jimfinnis/blodwen/docs/blod2.pdf

THIS WAY IS FORWARDS

power switch
Science

Locomotion

Fit PCs
