jimfinnis/blodwen/firmware/master/src/hwconfig.h

/**
 * @file
 * File used to describe configuration options for Arduino files
 * which share source, such as MAYBEPROGMEM - which is set in the
 * master's version of this file
 * 
 */

#ifndef __REGCONFIG_H
#define __REGCONFIG_H

/// this code is on the master

#define MASTER	1



#endif /* __REGCONFIG_H */
