jimfinnis/blodwen/roverScript/udpclient.cpp

/**
 * \file
 * Brief description. Longer description.
 *
 * 
 * \author $Author$
 * \date $Date$
 */




#include <stdio.h>
#include <sys/socket.h>
#include <netinet/in.h>
#include <arpa/inet.h>
#include <unistd.h>
#include <strings.h>
#include <string.h>
#include <fcntl.h>
#include <stdlib.h>
#include "udpclient.h"

const char *hostName=DEFAULT_HOSTNAME;

bool udpSend(const char *msg){
    sockaddr_in servaddr;
    int fd = socket(AF_INET,SOCK_DGRAM,0);
    if(fd<0){
        perror("cannot open socket");
        return false;
    }
    
    bzero(&servaddr,sizeof(servaddr));
    servaddr.sin_family = AF_INET;
    servaddr.sin_addr.s_addr = inet_addr(hostName);
    servaddr.sin_port = htons(PORT);
    if (sendto(fd, msg, strlen(msg)+1, 0, // +1 to include terminator
               (sockaddr*)&servaddr, sizeof(servaddr)) < 0){
        perror("cannot send message");
        close(fd);
        return false;
    }
    close(fd);
    return true;
}
