jimfinnis/blodwen/(commit log)

2017-03-29 Changes to docs to reflect new power regime, and eagle files for the boards.
    [rover board-4.brd, rover board-4.sch]
2017-03-29 Library now build with -Wall -pedantic. Warnings remove. Missing method returns added!
    [motorsim.h, rover.h, sim.cpp, slave.h]
2019-04-21 Include missing sys/select.h to satisfy fd_set and friends
    [comms.h]
2019-04-21 Do not track built assets
2025-02-13 A couple of warnings resolved: end of function without return in comms, and sys_errlist deprecation.
    [comms.h, slave.h]
2025-02-13 Doc changes! Rover now obtained with getInstance, and init() takes the wheel pair mask as second arg, not baud rate.
2025-02-21 Many changes to the Angort code to reflect changes to Angort in intervening years. These changes are currently UNTESTED
